Guimli/Vectrex-Schematic/LogicBoard 3GE/LogicBoard 3GE B&W.pdf

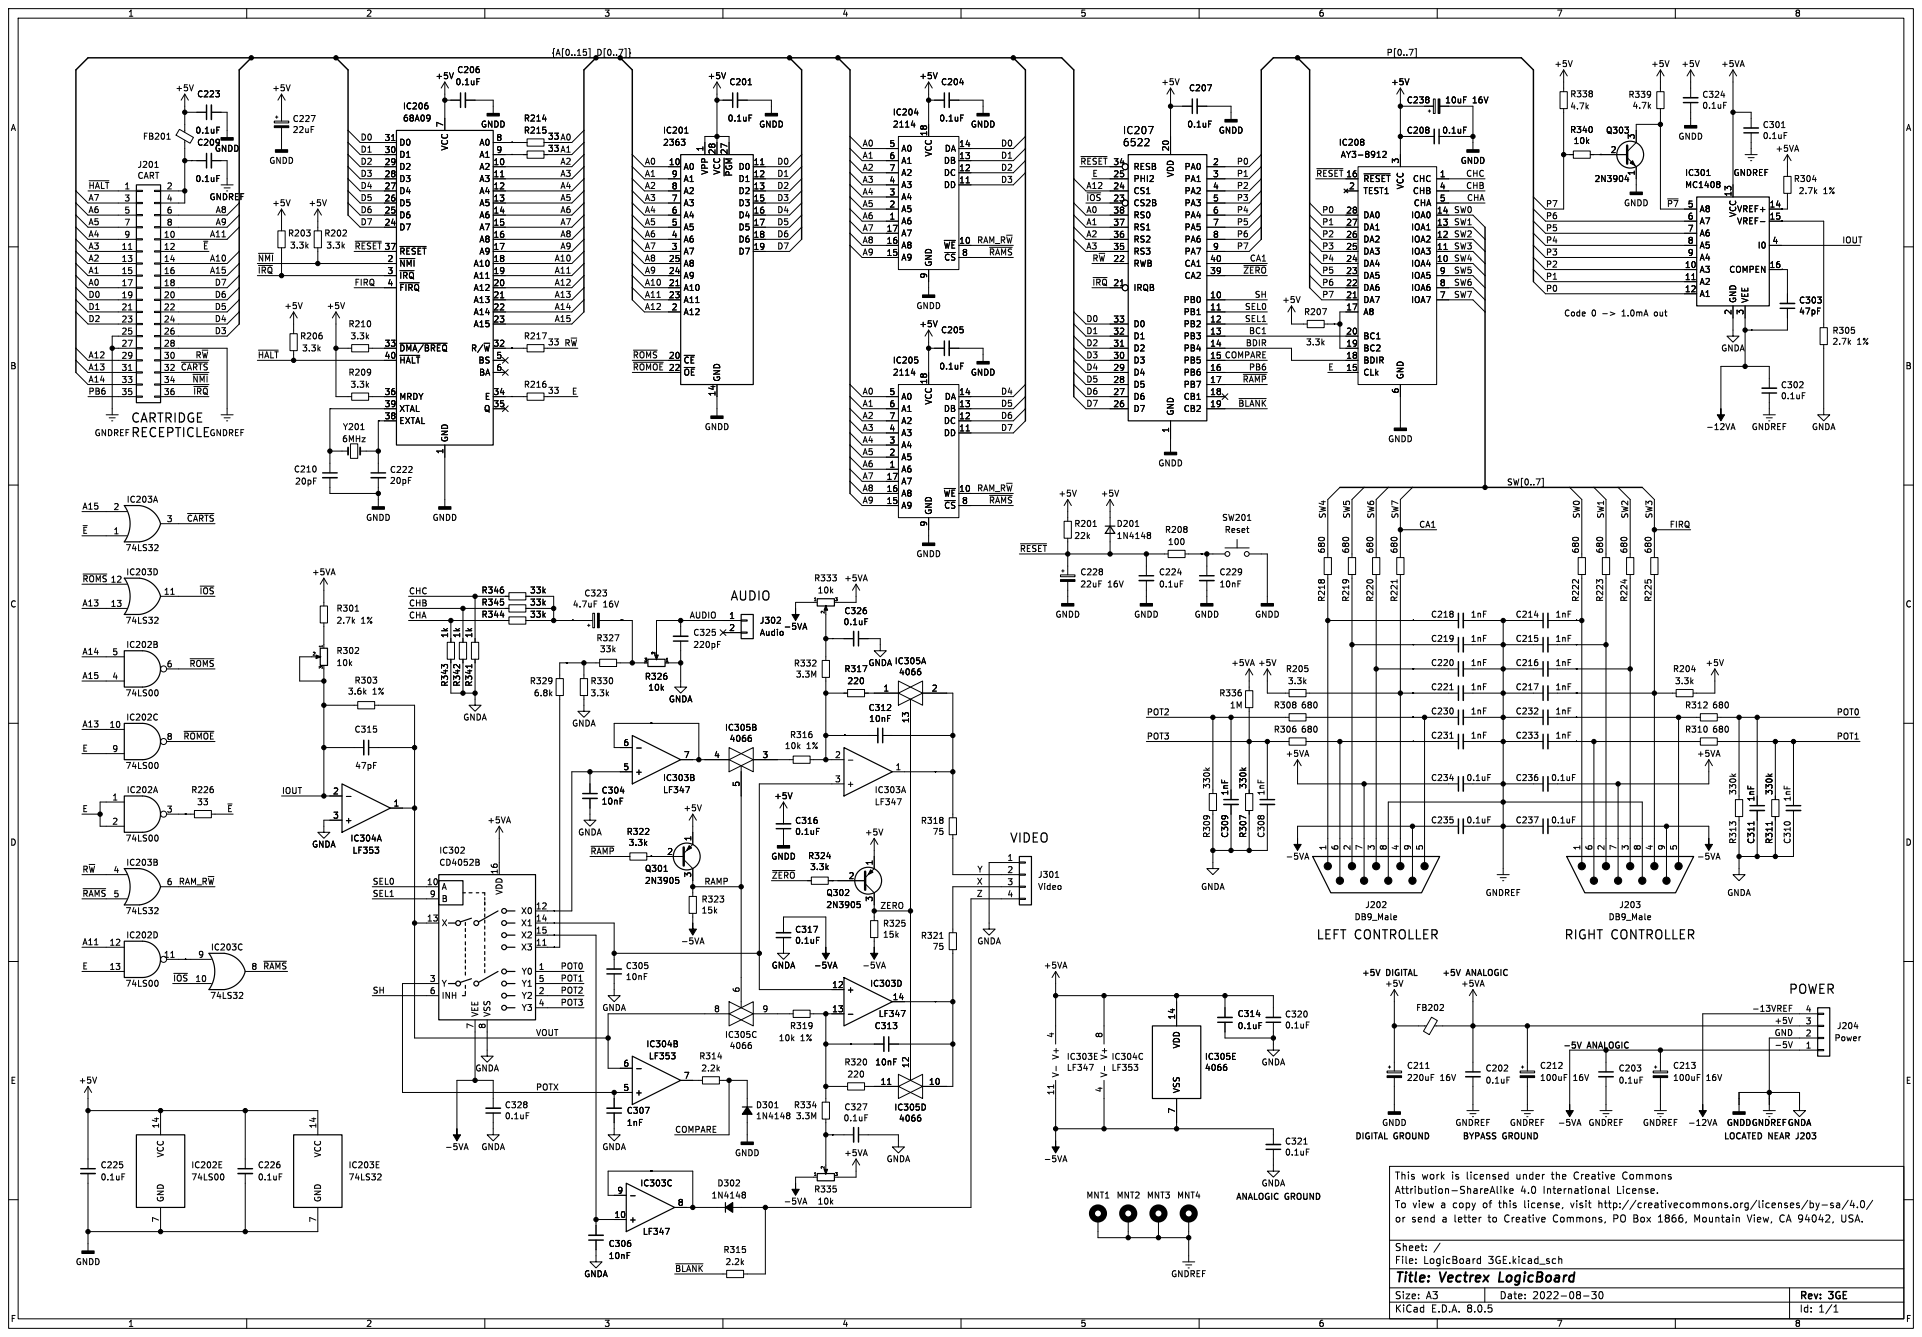
[picture p1: page 1]

1 A2 10 A3 11 A4 12 A5 13 A6 14 A7 15 A8 16 A9 17 A10 18 A11 19 ~{NMI} 2 A12 20 A13 21 A14 22 A15 23 D7 24 D6 25 D5 26 D4 27 D3 28 D2 29 ~{IRQ} 3 D1 30 D0 31 R/~{W}32 ~{DMA/BREQ} 33 E

1 A0 10 D0 11 D1 12 D2 13 GND 14 D3 15 D4 16 D5 17 D6 18 D7 19 A12 2 ~{CE} 20 A10 21 ~{OE} 22 A11 23 A9 24 A8 25 ~{PGM} 27 VCC 28 A7 3 A6 4 A5 5 A4 6 A3 7 A2 8 A1 9

Id: 1/1 Title: Vectrex LogicBoard
