Guimli/Vectrex-Schematic/PowerBoard/PowerBoard B&W.pdf

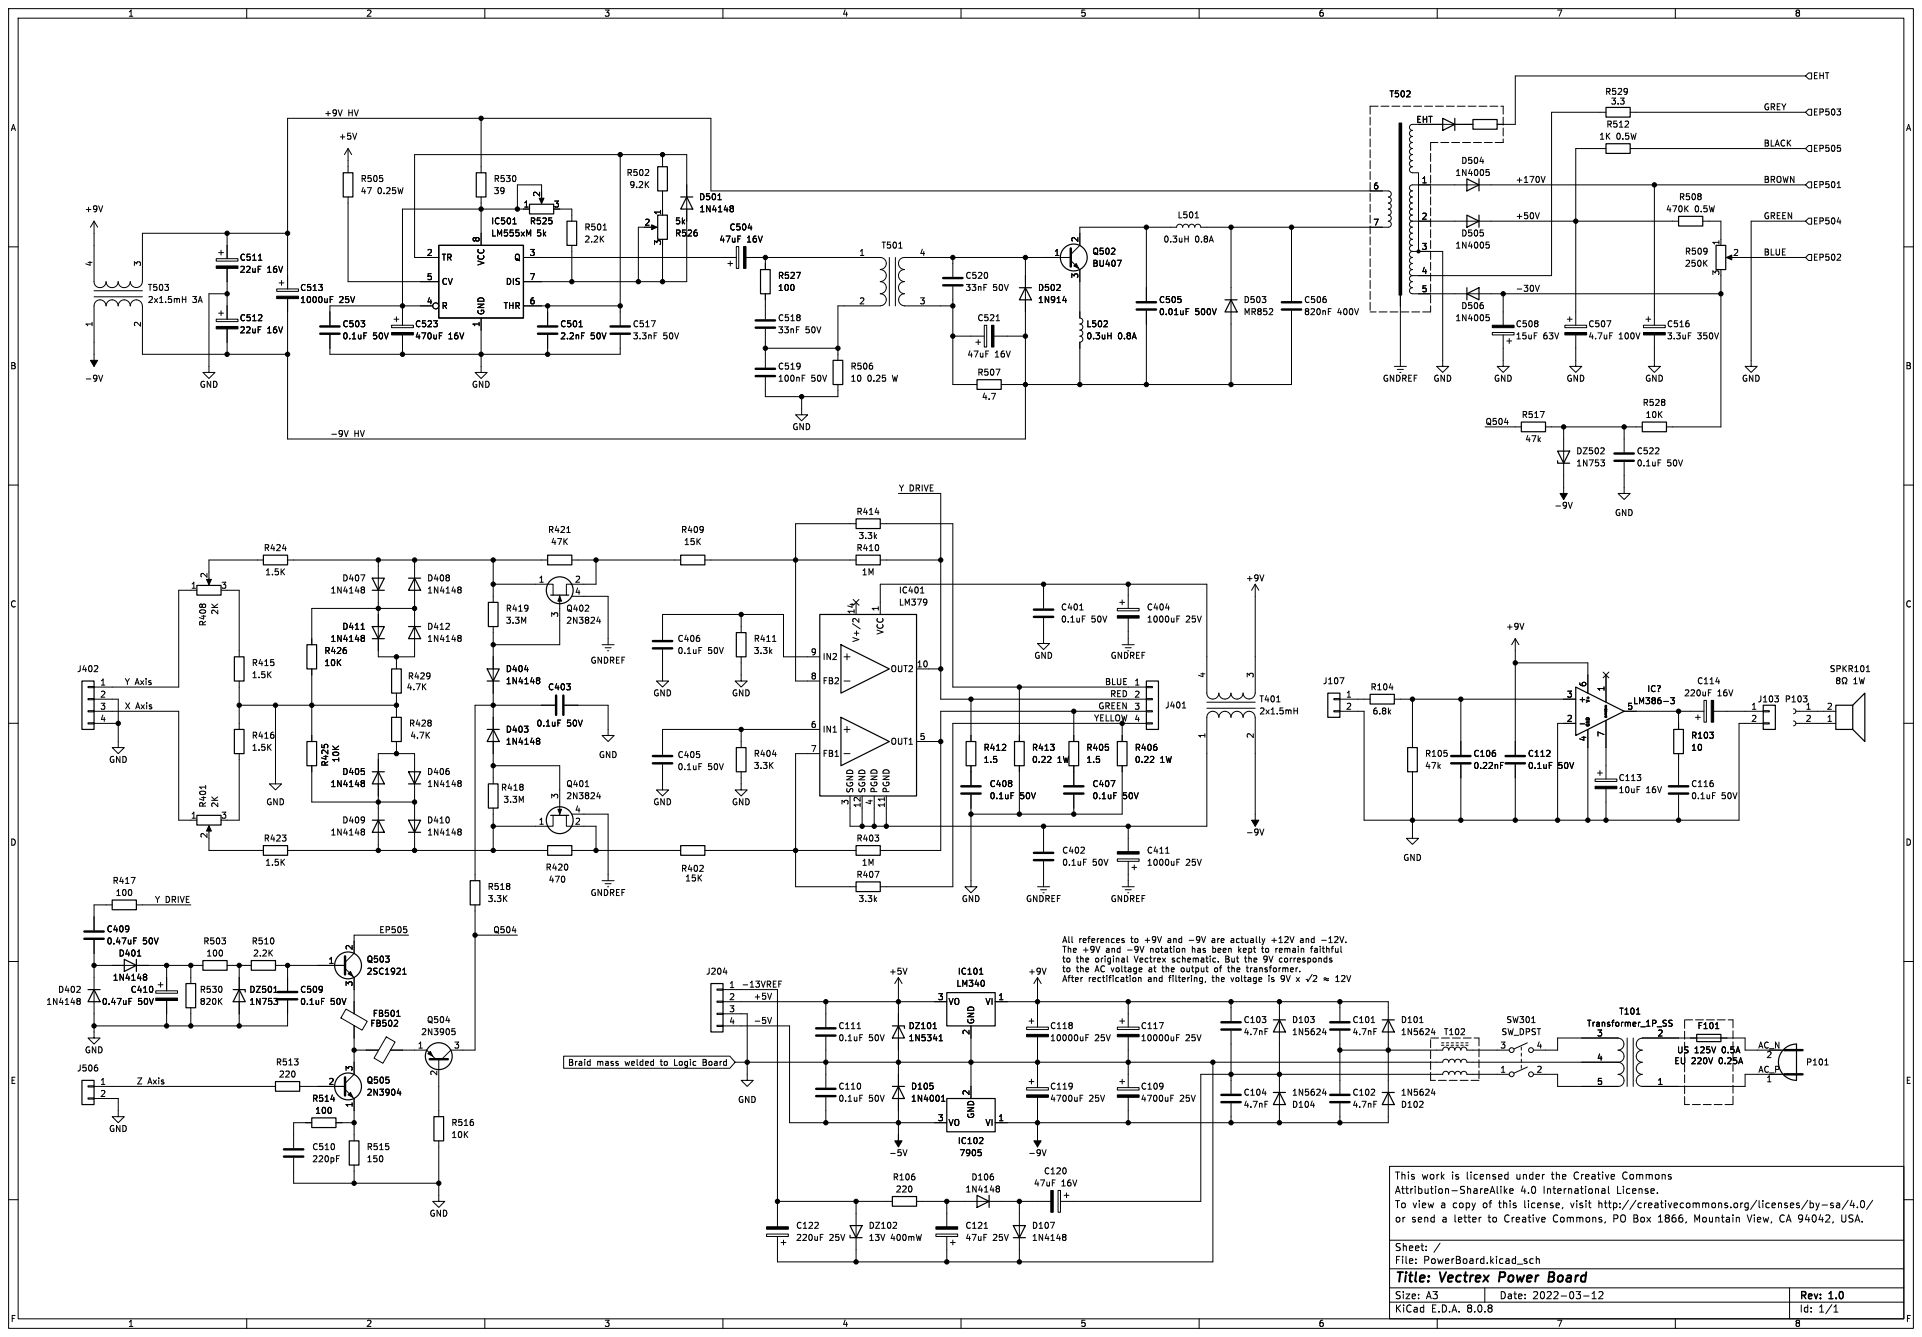
[picture p2: page 1]

Id: 1/1 Title: Vectrex Power Board
