Guimli/Vectrex-Schematic/PowerBoard/PowerBoard Color.pdf

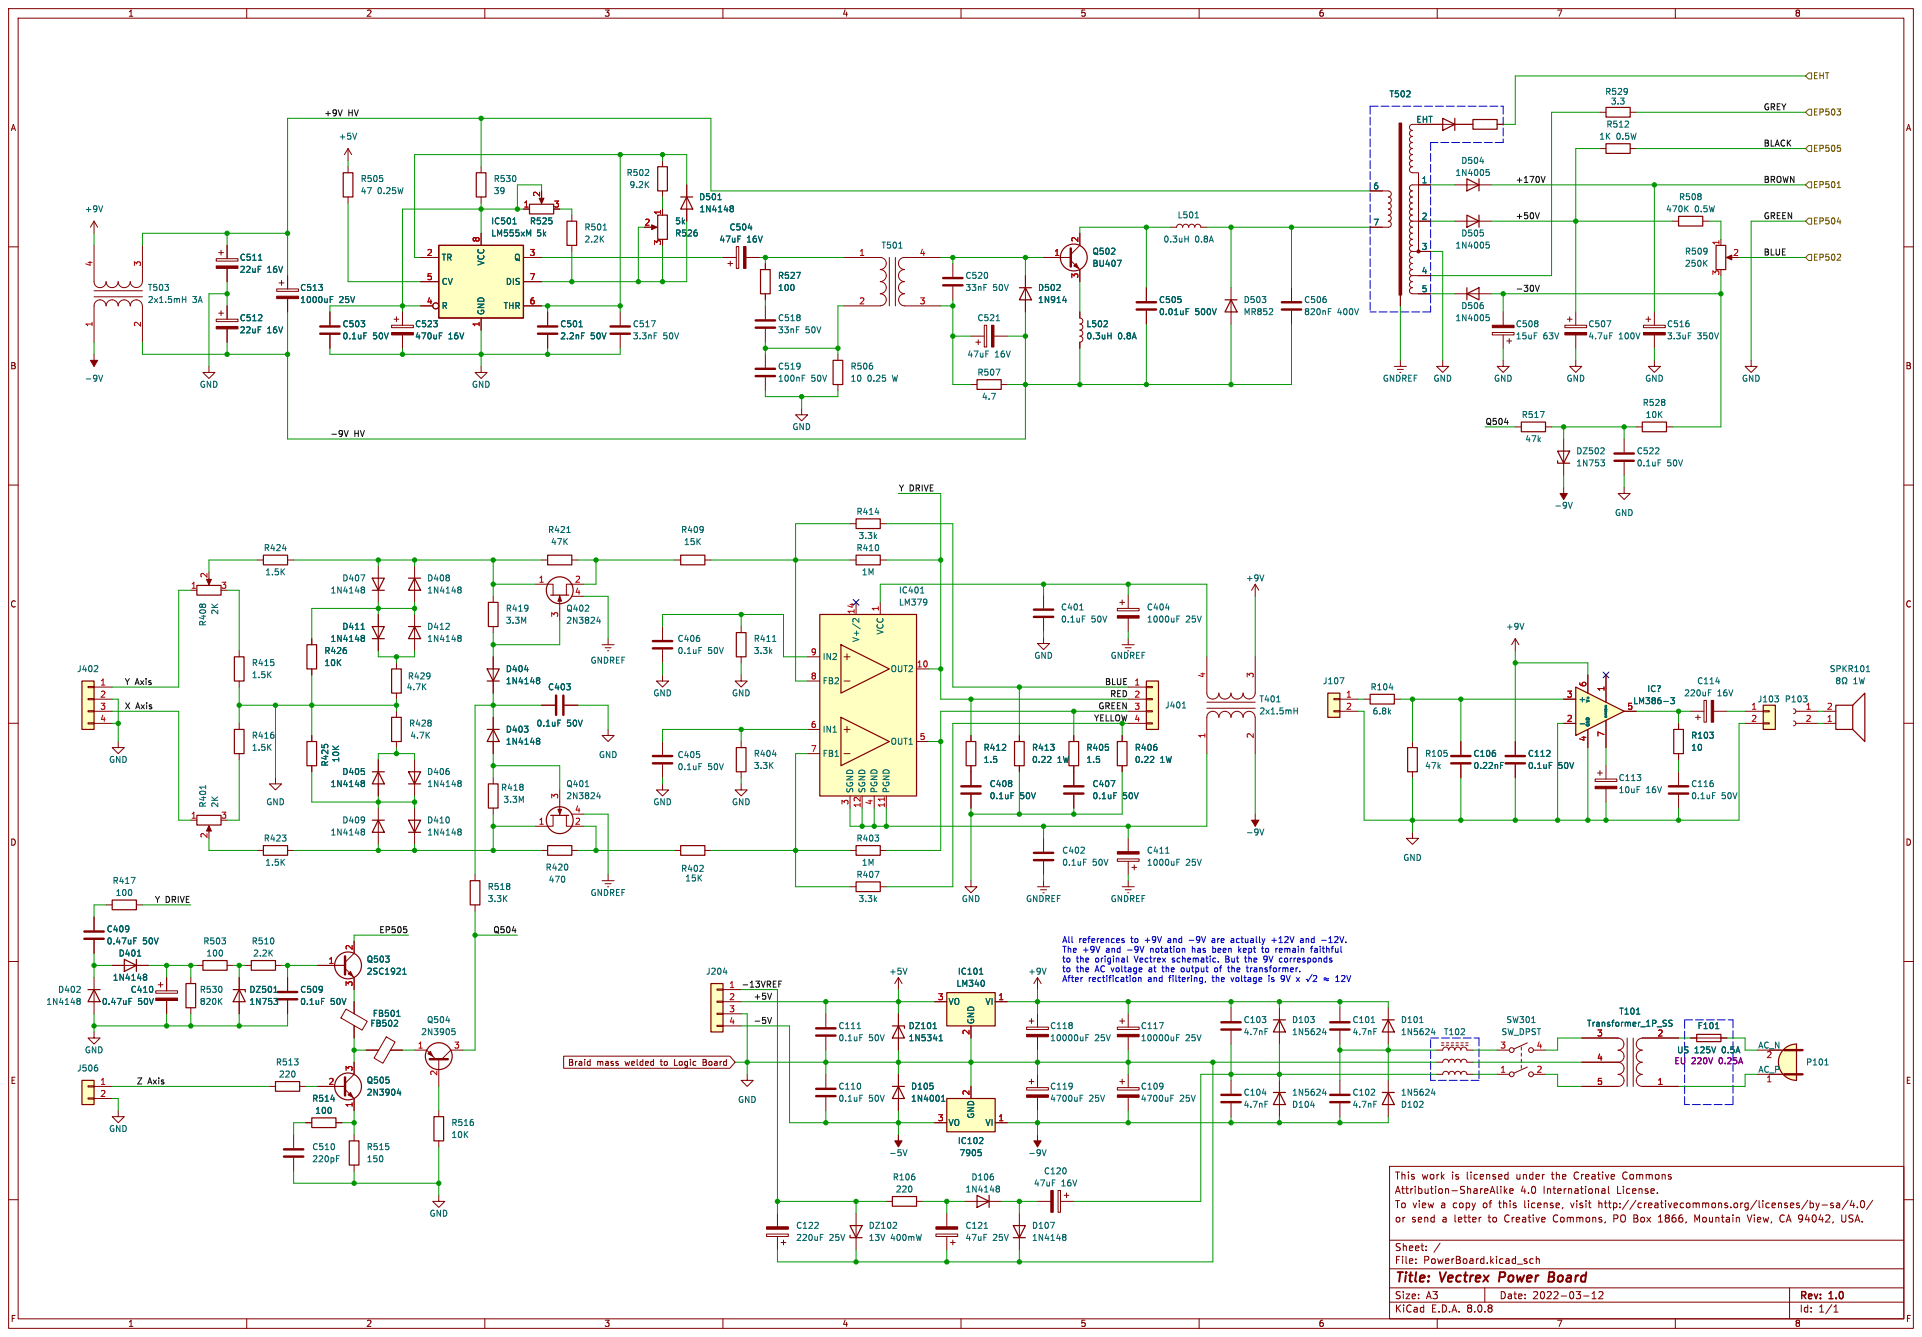
[picture p3: page 1]

Id: 1/1 Title: Vectrex Power Board
