Guimli/Vectrex-Schematic/CRTBoard/CRTBoard Color.pdf

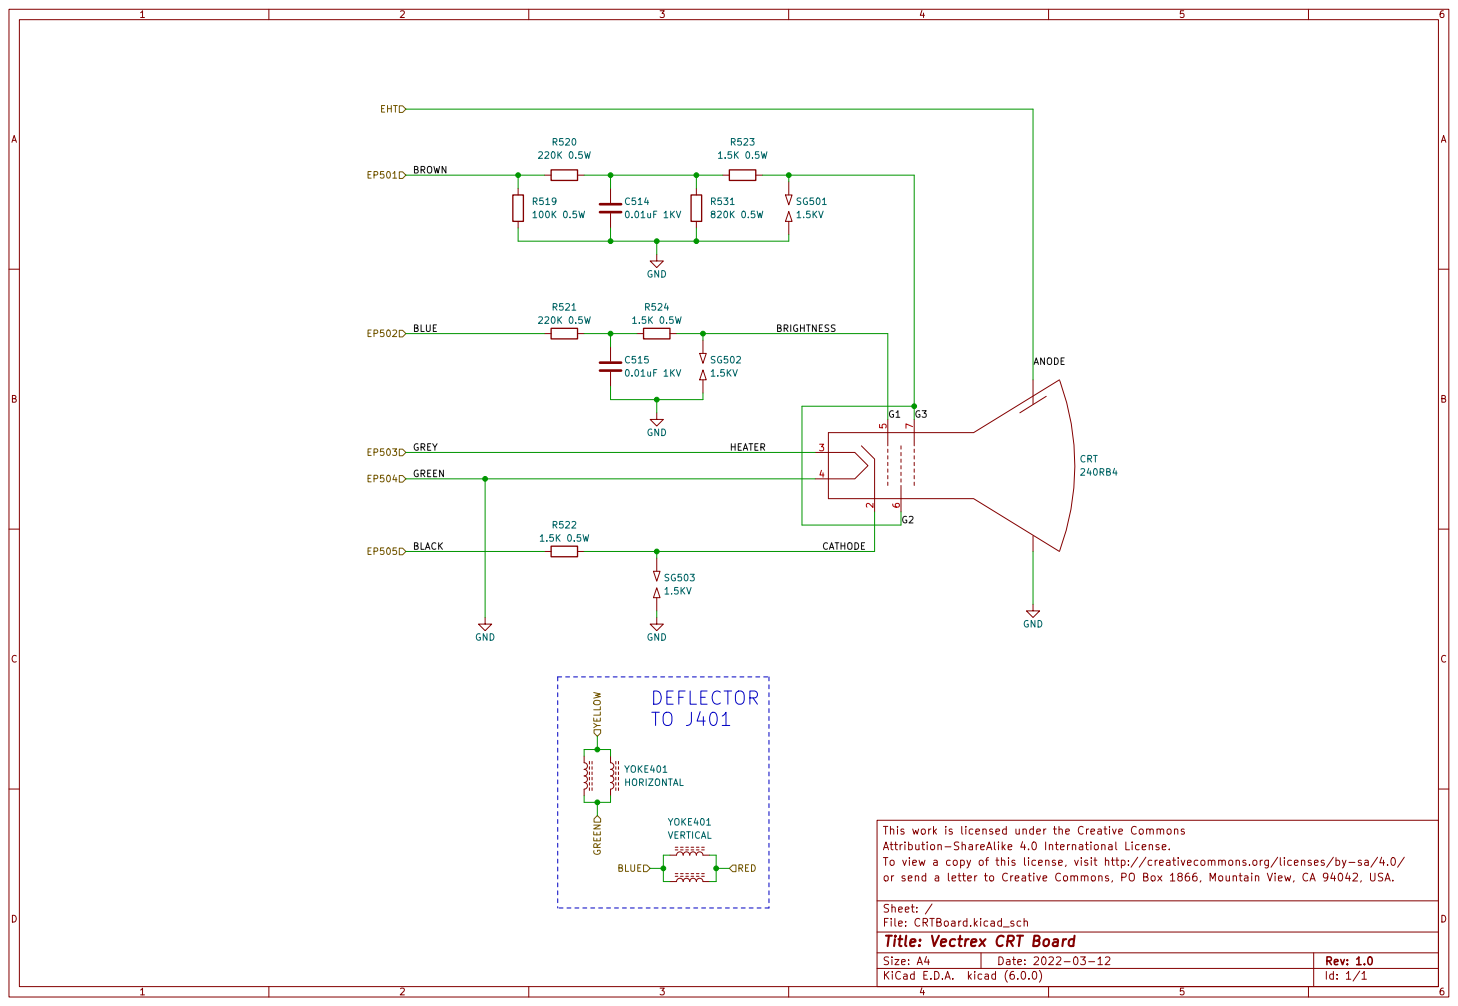
[picture p4: page 1]

To view a copy of this license, visit http://creativecommons.org/licenses/by-sa/4.0/ Attribution-ShareAlike 4.0 International License. This work is licensed under the Creative Commons YOKE401 HORIZONTAL C515

File: CRTBoard.kicad_sch Sheet: / or send a letter to Creative Commons, PO Box 1866, Mountain View, CA 94042, USA.

Id: 1/1 Title: Vectrex CRT Board
