Guimli/Vectrex-Schematic/CRTBoard/CRTBoard.kicad_sch

## KiCad design CRTBoard/CRTBoard.kicad_sch (2025-01-22)

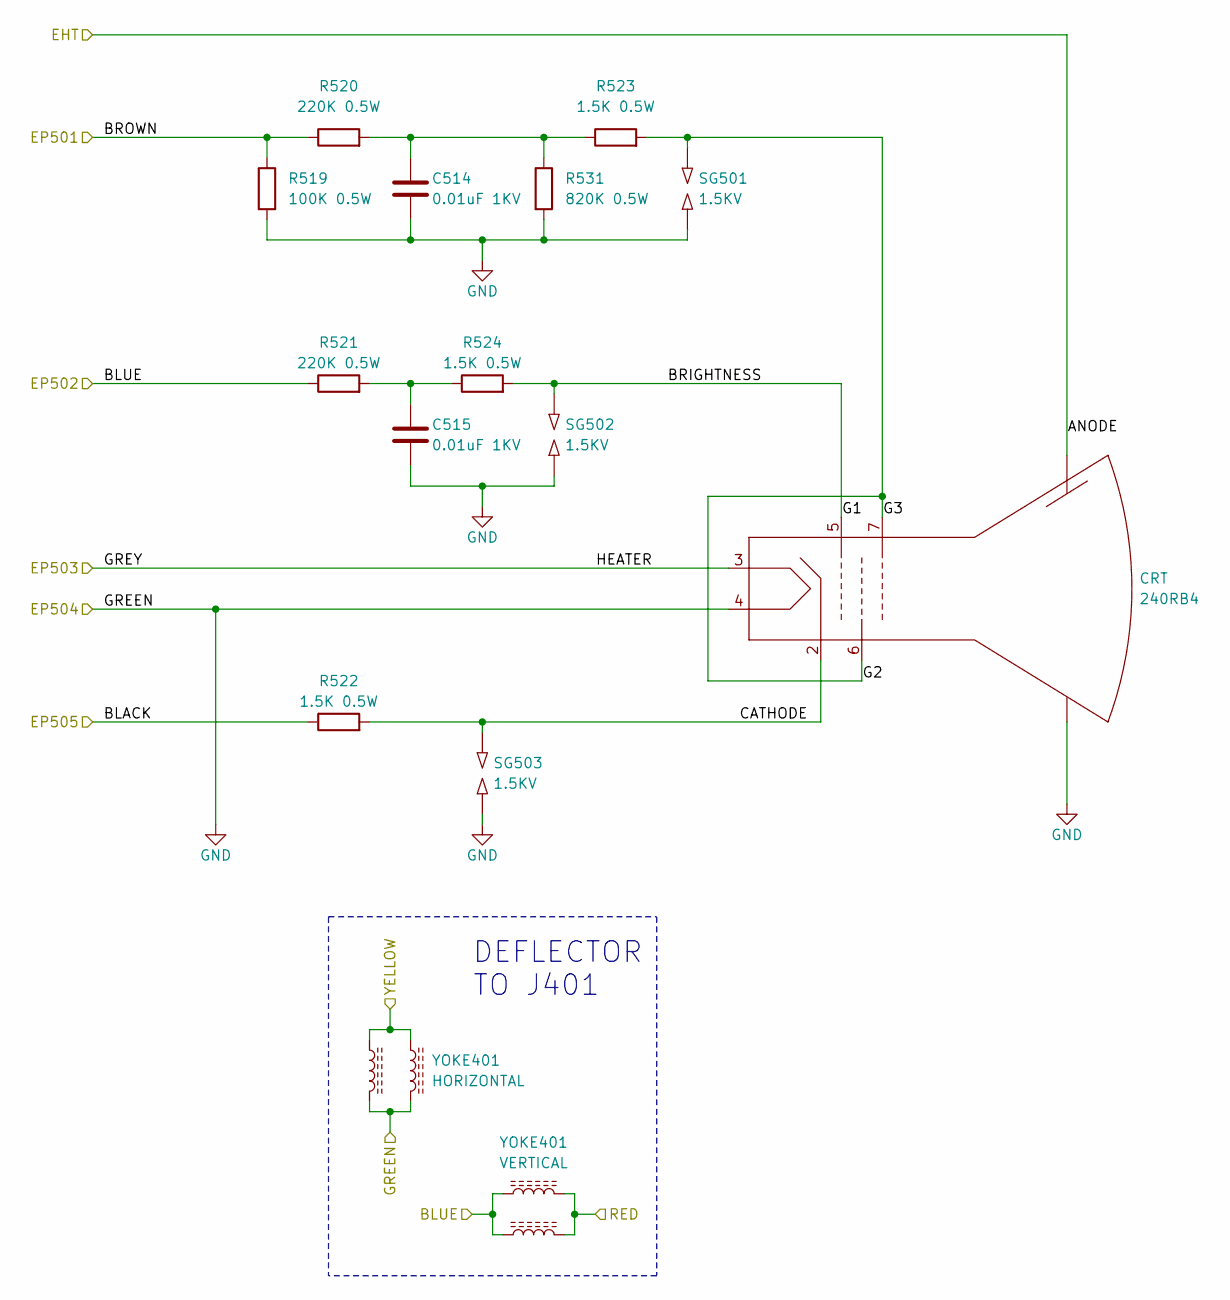
[picture p5: schematic CRTBoard.kicad_sch]

Parts:
C514, C515: 0.01uF 1KV
CRT: 240RB4
R519: 100K 0.5W
R520, R521: 220K 0.5W
R522, R523, R524: 1.5K 0.5W
R531: 820K 0.5W
SG501, SG502, SG503: 1.5KV
YOKE401: HORIZONTAL

Connections:
ANODE: CRT.
BLACK: R522.1
BLUE: R521.1, YOKE401.1
BRIGHTNESS: CRT.5, R524.2, SG502.2
BROWN: R519.1, R520.1
CATHODE: CRT.2, R522.2, SG503.2
EP503: CRT.3
EP504: CRT.4
G2: CRT.6, CRT.7, R523.2, SG501.2
GREEN: YOKE401.2
unnamed: C514.1, R520.2, R523.1, R531.1
unnamed: C514.2, R519.2, R531.2, SG501.1
unnamed: C515.1, R521.2, R524.1
unnamed: C515.2, SG502.1
RED: YOKE401.2
YELLOW: YOKE401.1

Notes on the sheet:
DEFLECTOR TO J401
