Guimli/Vectrex-Schematic/LogicBoard 3GE/LogicBoard 3GE.kicad_sch

## KiCad design LogicBoard 3GE/LogicBoard 3GE.kicad_sch (2025-01-22)

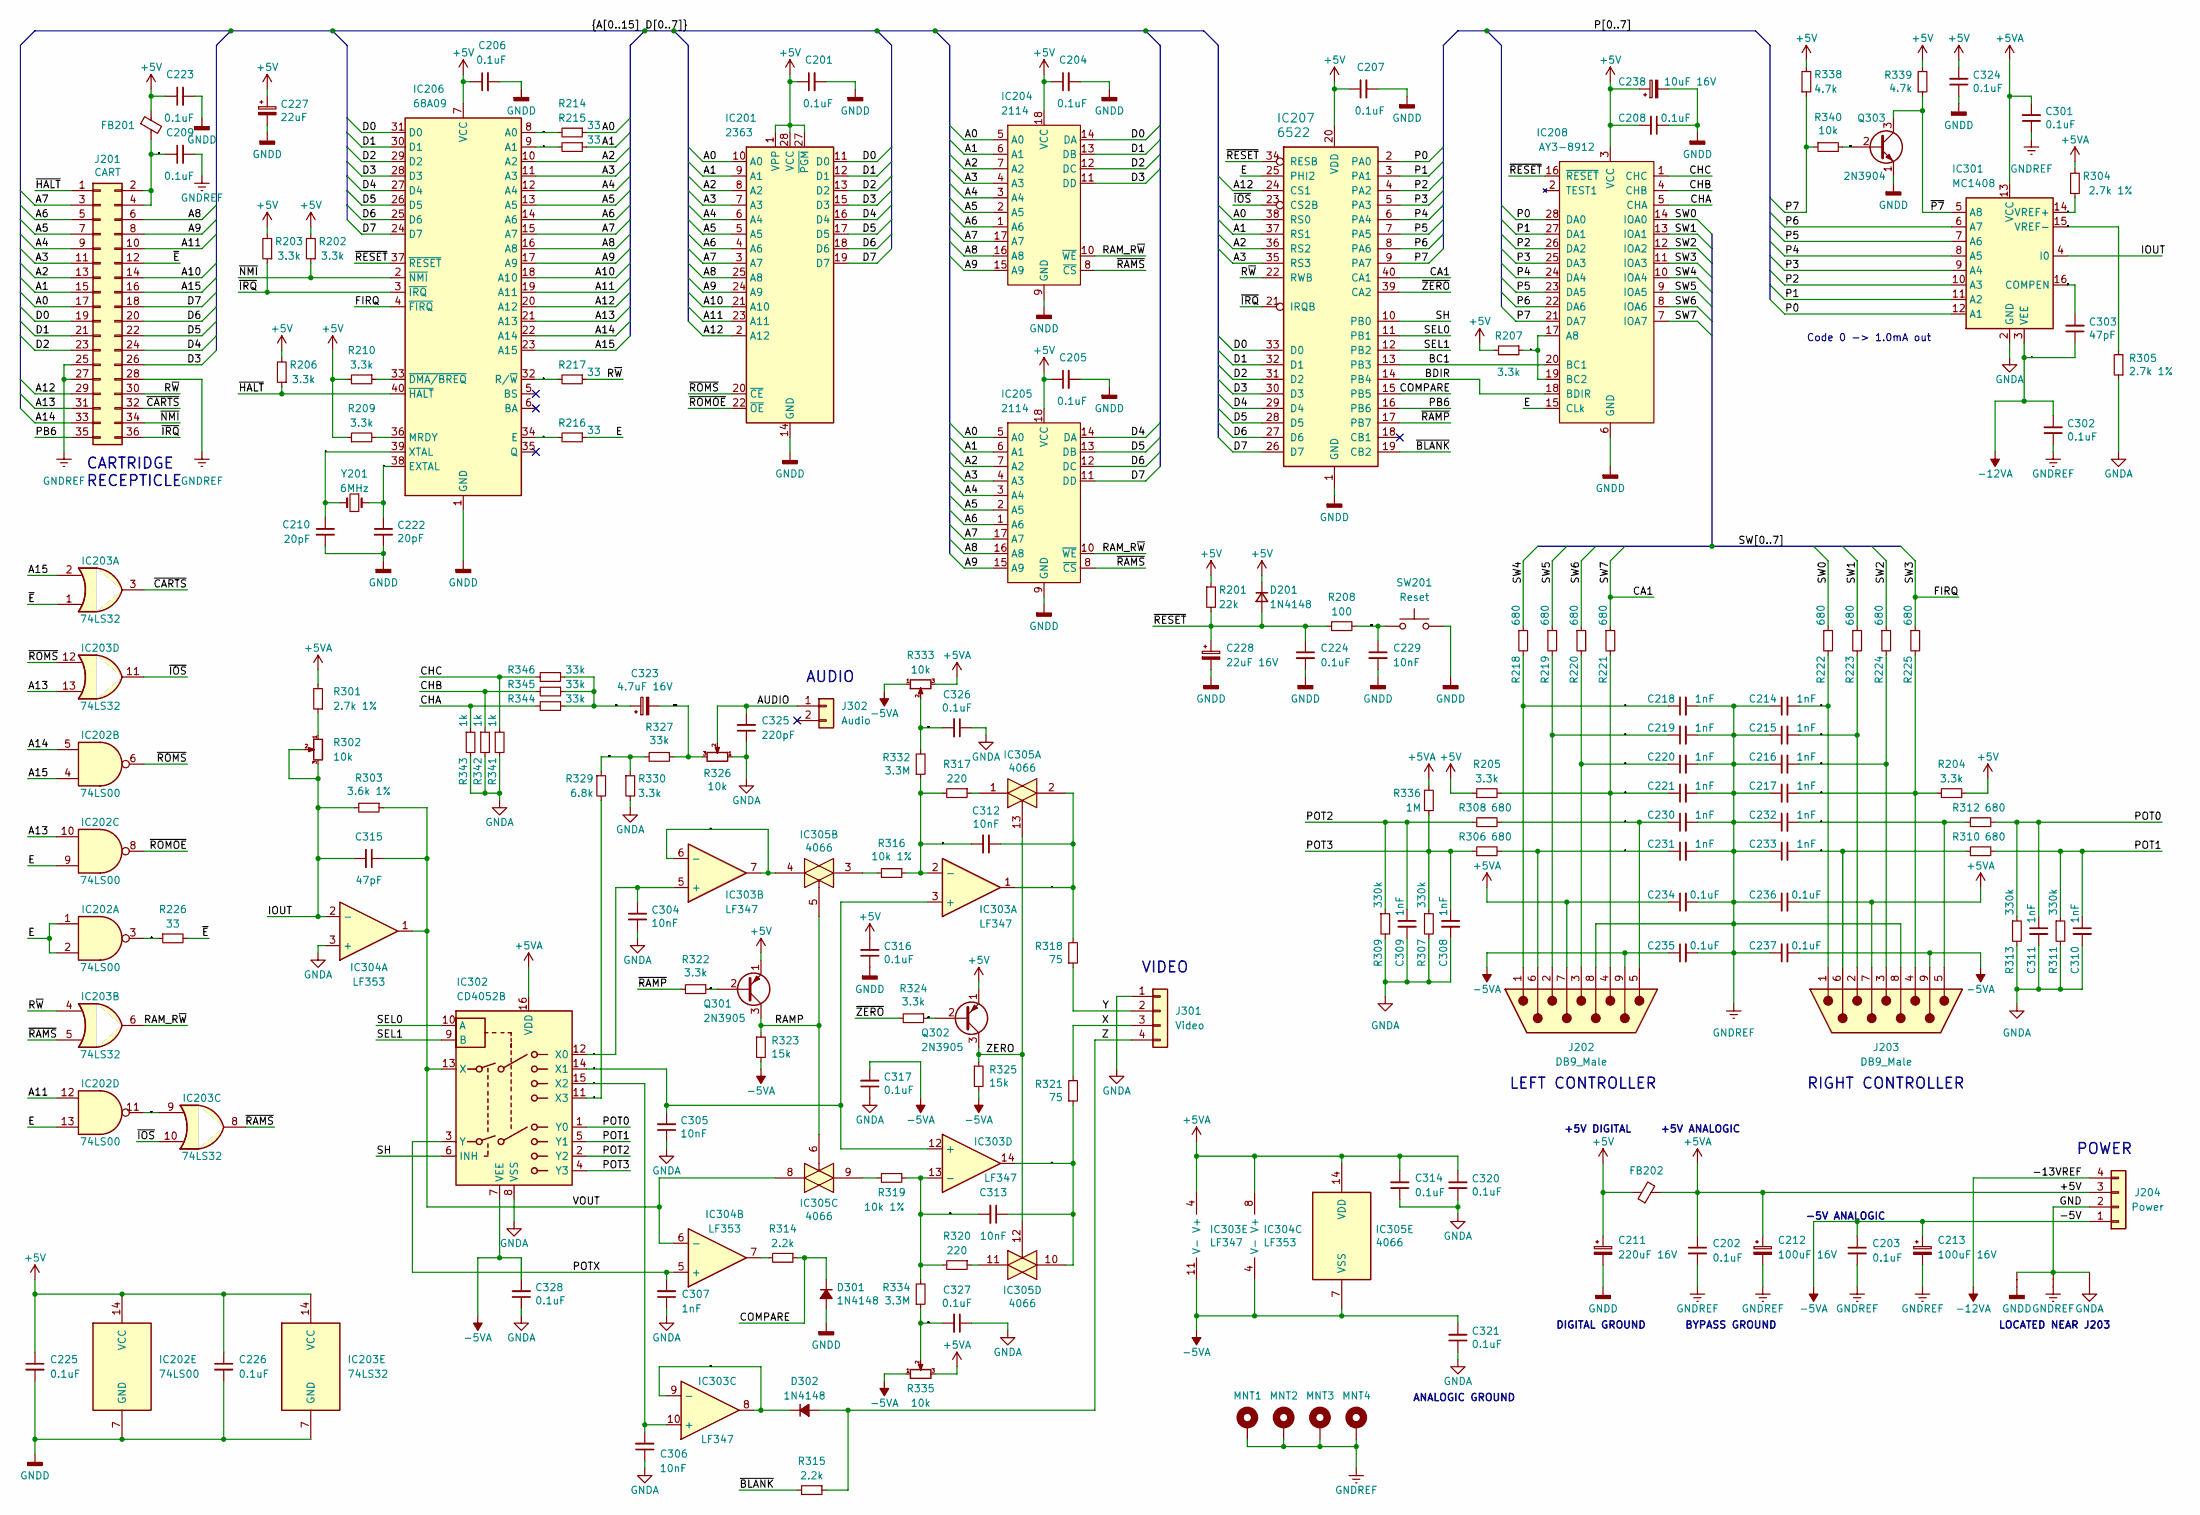
[picture p6: schematic LogicBoard 3GE.kicad_sch]

Parts:
C201, C204, C205, C206, C207, C208, C209, C223, C301, C302, C314, C316, C317, C320, C321, C324, C326, C327, C328: 0.1uF; C_Disc_D5.0mm_W2.5mm_P5.00mm; Mouser 581-SR215C104k
C202, C203, C224, C225, C226, C234, C235, C236, C237: 0.1uF; C_Disc_D5.0mm_W2.5mm_P5.00mm
C210, C222: 20pF; C_Disc_D5.0mm_W2.5mm_P5.00mm; Mouser 581-SR215A220kARTR1
C211: 220uF 16V; CP_Radial_D8.0mm_P2.50mm
C212, C213: 100uF 16V; CP_Radial_D8.0mm_P2.50mm
C214, C215, C216, C217, C218, C219, C220, C221, C230, C231, C232, C233: 1nF; C_Disc_D5.0mm_W2.5mm_P5.00mm
C227: 22uF; CP_Radial_Tantal_D5.5mm_P2.50mm; Mouser 647-UPW1A220MDD6TP
C228: 22uF 16V; CP_Radial_Tantal_D5.0mm_P2.50mm
C229: 10nF; C_Disc_D5.0mm_W2.5mm_P5.00mm
C238: 10uF 16V; CP_Radial_Tantal_D5.0mm_P2.50mm
C303, C315: 47pF; C_Disc_D5.0mm_W2.5mm_P5.00mm; Mouser 581-SR211A470JAR
C304, C305, C306: 10nF; C_Disc_D7.5mm_W5.0mm_P5.00mm; Mouser 810-FG28C0G2A472JRT6
C307, C308, C309, C310, C311: 1nF; C_Disc_D5.0mm_W2.5mm_P5.00mm; Mouser 581-SR211A102JAR
C312, C313: 10nF; C_Disc_D7.5mm_W5.0mm_P5.00mm; Mouser 810-FG28C0G2A103JRT6
C323: 4.7uF 16V; CP_Radial_D4.0mm_P2.00mm; Mouser 647-UkT1E4R7MDD1TD
C325: 220pF; C_Disc_D5.0mm_W2.5mm_P5.00mm; Mouser 581-SR211A221JAATR
D201: 1N4148; D_DO-34_SOD68_P12.70mm_Horizontal
D301, D302: 1N4148; D_DO-34_SOD68_P12.70mm_Horizontal; Mouser 512-1N4148
FB201, FB202: 96Ω @ 25MHz; L_Axial_L7.0mm_D3.3mm_P12.70mm_Horizontal_Fastron_MICC; Mouser 623-2743007112
IC201: 2363; DIP-28_W15.24mm
IC202: 74LS00; DIP-14_W7.62mm; Mouser 595-SN74LS00N
IC203: 74LS32; DIP-14_W7.62mm; Mouser 595-SN74LS32N
IC204, IC205: 2114; DIP-18_W7.62mm
IC206: 68A09; DIP-40_W15.24mm
IC207: 6522; DIP-40_W15.24mm; Mouser 955-W65C22S6TPG-14
IC208: AY3-8912; DIP-28_W15.24mm
IC301: MC1408; DIP-16_W7.62mm; Mouser 926-DAC0808LCN/NOPB
IC302: CD4052B; DIP-16_W7.62mm; Mouser 595-CD4052BE
IC303: LF347; DIP-14_W7.62mm; Mouser 595-LF347N
IC304: LF353; DIP-8_W7.62mm; Mouser 595-LF353P
IC305: 4066; DIP-14_W7.62mm; Mouser 595-CD4066BE
J201: CART; SULLINS_EBC18DRAS; Mouser 587-395-036
J202, J203: DB9_Male; DSUB-9_Male_Horizontal_Vectrex
J204: Power; Molex_KK-396_A-41791-0004_1x04_P3.96mm_Vertical
J301: Video; Molex_KK-254_AE-6410-04A_1x04_P2.54mm_Vertical
J302: Audio; Molex_KK-254_AE-6410-02A_1x02_P2.54mm_Vertical
MNT1, MNT2, MNT3, MNT4: MountingHole_Pad; MountingHole_3.5mm_Pad
Q301, Q302: 2N3905; TO-92_Wide
Q303: 2N3904; TO-92_Wide; Mouser 512-2N3904TA
R201: 22k; R_Axial_DIN0207_L6.3mm_D2.5mm_P12.70mm_Horizontal
R202, R203, R206, R207, R209, R210, R322, R324: 3.3k; R_Axial_DIN0207_L6.3mm_D2.5mm_P12.70mm_Horizontal; Mouser 603-CFR-25JR-523k3
R204, R205: 3.3k; R_Axial_DIN0207_L6.3mm_D2.5mm_P12.70mm_Horizontal
R208: 100; R_Axial_DIN0207_L6.3mm_D2.5mm_P12.70mm_Horizontal
R214, R215, R216, R217, R226: 33; R_Axial_DIN0207_L6.3mm_D2.5mm_P12.70mm_Horizontal; Mouser 603-CFR-25JR-5233R
R218, R219, R220, R221, R222, R223, R224, R225, R306, R308, R310, R312: 680; R_Axial_DIN0207_L6.3mm_D2.5mm_P12.70mm_Horizontal
R301, R304, R305: 2.7k 1%; R_Axial_DIN0207_L6.3mm_D2.5mm_P12.70mm_Horizontal; Mouser 603-MFR-25FRF522k49
R302: 10k; Potentiometer_ACP_CA14-H5_Horizontal; Mouser 531-PT10H-5k-S
R303: 3.6k 1%; R_Axial_DIN0207_L6.3mm_D2.5mm_P12.70mm_Horizontal; Mouser 603-MFR-25FRF52-2k61
R307, R309, R311, R313: 330k; R_Axial_DIN0207_L6.3mm_D2.5mm_P12.70mm_Horizontal; Mouser 603-CFR-25JR-52-330k
R314, R315: 2.2k; R_Axial_DIN0207_L6.3mm_D2.5mm_P12.70mm_Horizontal; Mouser 603-CFR-25JR-522k2
R316, R319: 10k 1%; R_Axial_DIN0207_L6.3mm_D2.5mm_P12.70mm_Horizontal; Mouser 603-MFR-25FRF5210k
R317, R320: 220; R_Axial_DIN0207_L6.3mm_D2.5mm_P12.70mm_Horizontal; Mouser 603-CFR-25JR-52220R
R318, R321: 75; R_Axial_DIN0207_L6.3mm_D2.5mm_P12.70mm_Horizontal; Mouser 603-MFR-25FTE52-3M3
R323, R325: 15k; R_Axial_DIN0207_L6.3mm_D2.5mm_P12.70mm_Horizontal; Mouser 603-CFR-25JR-5215k
R326: 10k; Potentiometer_UndLab_Horizontal; Mouser 531-PT10H-10k-S
R327, R344, R345, R346: 33k; R_Axial_DIN0207_L6.3mm_D2.5mm_P12.70mm_Horizontal; Mouser 603-CFR-25JR-52-33k
R329: 6.8k; R_Axial_DIN0207_L6.3mm_D2.5mm_P12.70mm_Horizontal; Mouser 603-CFR-25JR-52-33k
R330: 3.3k; R_Axial_DIN0207_L6.3mm_D2.5mm_P12.70mm_Horizontal; Mouser 603-CFR-25JR-52-33k
R332, R334: 3.3M; R_Axial_DIN0207_L6.3mm_D2.5mm_P12.70mm_Horizontal; Mouser 603-MFR-25FTE52-3M3
R333, R335: 10k; Potentiometer_ACP_CA14-H5_Horizontal; Mouser 531-PT10H-10k-S
R336: 1M; R_Axial_DIN0207_L6.3mm_D2.5mm_P12.70mm_Horizontal; Mouser 603-CFR-25JR-52-330k
R338, R339: 4.7k; R_Axial_DIN0207_L6.3mm_D2.5mm_P12.70mm_Horizontal; Mouser 603-CFR-25JR-524k7
R340: 10k; R_Axial_DIN0207_L6.3mm_D2.5mm_P12.70mm_Horizontal; Mouser 603-CFR-25JR-5210k
R341, R342, R343: 1k; R_Axial_DIN0207_L6.3mm_D2.5mm_P12.70mm_Horizontal; Mouser 603-CFR-25JR-521k
SW201: Reset; TestPoint_Bridge_Pitch5.08mm_Drill1.3mm
W1, W2, W3: W
Y201: 6MHz; Crystal_HC49-U_Horizontal_1EP_style3; Mouser 815-AB-6-B2

Connections:
+5V: C201.1, C204.1, C205.1, C206.1, C207.1, C208.2, C211.1, C223.1, C225.1, C226.1, C227.1, C238.1, C316.2, C324.2, D201.1 (k), FB201.1, FB202.1, IC201.1 (VPP), IC201.27 (~PGM), IC201.28 (VCC), IC202.14 (VCC), IC203.14 (VCC), IC204.18 (VCC), IC205.18 (VCC), IC206.7 (VCC), IC207.20 (VDD), IC208.3 (VCC), Q301.1 (E), Q302.1 (E), R201.1, R202.2, R203.2, R204.2, R205.1, R206.2, R207.2, R209.1, R210.2, R338.2, R339.2
+5VA: C202.1, C212.1, C234.1, C236.2, C301.2, C314.2, C320.2, FB202.2, IC301.13 (VCC), IC302.16 (VDD), IC303.4 (V+), IC304.8 (V+), IC305.14 (VDD), J202.7, J203.7, J204.3, R301.2, R304.2, R333.3, R335.3, R336.1
+5V_CART: C209.1, FB201.2, J201.2, J201.4
-5VA: C203.1, C213.1, C235.1, C237.2, C317.2, C321.2, C328.2, IC302.7 (VEE), IC303.11 (V-), IC304.4 (V-), IC305.7 (VSS), J202.9, J203.9, J204.1, R323.2, R325.2, R333.1, R335.1
-13VREF: J204.4
A0: IC201.10 (A0), IC204.5 (A0), IC205.5 (A0), IC207.38 (RS0), J201.17, R214.1
A1: IC201.9 (A1), IC204.6 (A1), IC205.6 (A1), IC207.37 (RS1), J201.15, R215.1
A2: IC201.8 (A2), IC204.7 (A2), IC205.7 (A2), IC206.10 (A2), IC207.36 (RS2), J201.13
A3: IC201.7 (A3), IC204.4 (A3), IC205.4 (A3), IC206.11 (A3), IC207.35 (RS3), J201.11
A4: IC201.6 (A4), IC204.3 (A4), IC205.3 (A4), IC206.12 (A4), J201.9
A5: IC201.5 (A5), IC204.2 (A5), IC205.2 (A5), IC206.13 (A5), J201.7
A6: IC201.4 (A6), IC204.1 (A6), IC205.1 (A6), IC206.14 (A6), J201.5
A7: IC201.3 (A7), IC204.17 (A7), IC205.17 (A7), IC206.15 (A7), J201.3
A8: IC201.25 (A8), IC204.16 (A8), IC205.16 (A8), IC206.16 (A8), J201.6
A9: IC201.24 (A9), IC204.15 (A9), IC205.15 (A9), IC206.17 (A9), J201.8
A10: IC201.21 (A10), IC206.18 (A10), J201.14
A11: IC201.23 (A11), IC202.12, IC206.19 (A11), J201.10
A12: IC201.2 (A12), IC206.20 (A12), IC207.24 (CS1), J201.29
A13: IC202.10, IC203.13, IC206.21 (A13), J201.31
A14: IC202.5, IC206.22 (A14), J201.33
A15: IC202.4, IC203.2, IC206.23 (A15), J201.16
AUDIO: C325.2, J302.1, R326.2
BC1: IC207.13 (PB3), IC208.20 (BC1)
BC2: IC208.17 (A8), IC208.19 (BC2), R207.1
BDIR: IC207.14 (PB4), IC208.18 (BDIR)
CA1: IC207.40 (CA1), IC208.7 (IOA7), R221.1
CH(A+B+C): C323.1, R344.1, R345.1, R346.1
CH(A+B+C)+DIGITAL_AUDIO: C323.2, R326.3, R327.1
CHA: IC208.5 (CHA), R343.1, R344.2
CHB: IC208.4 (CHB), R342.1, R345.2
CHC: IC208.1 (CHC), R341.1, R346.2
COMPARE: D301.1 (k), IC207.15 (PB5), R314.1
COMPEN: C303.2, IC301.16 (COMPEN)
CPU_A0: IC206.8 (A0), R214.2
CPU_A1: IC206.9 (A1), R215.2
CPU_E: IC206.34 (E), R216.2
CPU_R~W: IC206.32 (R/~W), R217.2
D0: IC201.11 (D0), IC204.14 (DA), IC206.31 (D0), IC207.33 (D0), J201.19
D1: IC201.12 (D1), IC204.13 (DB), IC206.30 (D1), IC207.32 (D1), J201.21
D2: IC201.13 (D2), IC204.12 (DC), IC206.29 (D2), IC207.31 (D2), J201.23
D3: IC201.15 (D3), IC204.11 (DD), IC206.28 (D3), IC207.30 (D3), J201.26
D4: IC201.16 (D4), IC205.14 (DA), IC206.27 (D4), IC207.29 (D4), J201.24
D5: IC201.17 (D5), IC205.13 (DB), IC206.26 (D5), IC207.28 (D5), J201.22
D6: IC201.18 (D6), IC205.12 (DC), IC206.25 (D6), IC207.27 (D6), J201.20
D7: IC201.19 (D7), IC205.11 (DD), IC206.24 (D7), IC207.26 (D7), J201.18
DIGITAL_AUDIO: R327.2, R329.1, R330.1
E: IC202.1, IC202.2, IC202.9, IC202.13, IC207.25 (PHI2), IC208.15 (CLk), R216.1
EXTAL: C222.1, IC206.38 (EXTAL), Y201.1
FIRQ: IC206.4 (~FIRQ), IC208.11 (IOA3), R225.1
GND: J204.2, W1.2, W2.2, W3.2
GNDA: C304.2, C305.1, C306.1, C307.1, C308.2, C309.2, C310.2, C311.2, C314.1, C317.1, C320.1, C321.1, C325.1, C326.1, C327.1, C328.1, IC301.2 (GND), IC302.8 (VSS), IC304.3 (+), J301.1, R305.1, R307.2, R309.2, R311.2, R313.2, R326.1, R330.2, R341.2, R342.2, R343.2, W3.1
GNDD: C201.2, C204.2, C205.2, C206.2, C207.2, C208.1, C210.2, C211.2, C222.2, C223.2, C224.2, C225.2, C226.2, C227.2, C228.2, C229.2, C238.2, C316.1, C324.1, D301.2 (A), IC201.14 (GND), IC202.7 (GND), IC203.7 (GND), IC204.9 (GND), IC205.9 (GND), IC206.1 (GND), IC207.1 (GND), IC208.6 (GND), Q303.1 (E), SW201.2, W1.1
GNDREF: C202.2, C203.2, C209.2, C212.2, C213.2, C214.1, C215.1, C216.1, C217.1, C218.2, C219.2, C220.2, C221.2, C230.2, C231.2, C232.1, C233.1, C234.2, C235.2, C236.1, C237.1, C301.1, C302.1, J201.25, J201.27, J201.28, J202.8, J203.8, MNT1.1, MNT2.1, MNT3.1, MNT4.1, W2.1
IC202A_~E: IC202.3, R226.1
IC303A_FB: C312.2, IC303.2 (-), R316.1, R317.2, R332.1
IC303A_Y: C312.1, IC303.1, IC305.2, R318.2
IC303B_FB: IC303.6 (-), IC303.7, IC305.4
IC303C_FB: D302.1 (k), IC303.8, IC303.9 (-)
IC303D_FB: C313.2, IC303.13 (-), R319.1, R320.2, R334.2
IC303D_X: C313.1, IC303.14, IC305.10, R321.1
IOUT: C315.2, IC301.4 (I0), IC304.2 (-), R302.2, R302.3, R303.2
J202_B1: C218.1, J202.1, R218.2
J202_B2: C219.1, J202.2, R219.2
J202_B3: C220.1, J202.3, R220.2
J202_B4: C221.1, J202.4, R205.2, R221.2
J202_X: C230.1, J202.5, R308.2
J202_Y: C231.1, J202.6, R306.2
J203_B1: C214.2, J203.1, R222.2
J203_B2: C215.2, J203.2, R223.2
J203_B3: C216.2, J203.3, R224.2
J203_B4: C217.2, J203.4, R204.1, R225.2
J203_X: C232.2, J203.5, R312.1
J203_Y: C233.2, J203.6, R310.1
unnamed: IC206.33 (~DMA/BREQ), R210.1
unnamed: IC206.36 (MRDY), R209.2
unnamed: IC304.7, R314.2
unnamed: IC305.1, R317.1
unnamed: IC305.3, R316.2
unnamed: IC305.9, R319.2
unnamed: IC305.11, R320.1
unnamed: R301.1, R302.1
P0: IC207.2 (PA0), IC208.28 (DA0), IC301.12 (A1)
P1: IC207.3 (PA1), IC208.27 (DA1), IC301.11 (A2)
P2: IC207.4 (PA2), IC208.26 (DA2), IC301.10 (A3)
P3: IC207.5 (PA3), IC208.25 (DA3), IC301.9 (A4)
P4: IC207.6 (PA4), IC208.24 (DA4), IC301.8 (A5)
P5: IC207.7 (PA5), IC208.23 (DA5), IC301.7 (A6)
P6: IC207.8 (PA6), IC208.22 (DA6), IC301.6 (A7)
P7: IC207.9 (PA7), IC208.21 (DA7), R338.1, R340.1
PB6: IC207.16 (PB6), J201.35
POT0: C311.1, IC302.1 (Y0), R312.2, R313.1
POT1: C310.1, IC302.5 (Y1), R310.2, R311.1
POT2: C309.1, IC302.2 (Y2), R308.1, R309.1
POT3: C308.1, IC302.4 (Y3), R306.1, R307.1, R336.2
POTX: C307.2, IC302.3 (Y), IC304.5 (+)
Q301_BASE: Q301.2 (B), R322.1
Q302_BASE: Q302.2 (B), R324.1
Q303_BASE: Q303.2 (B), R340.2
RAMP: IC305.5, IC305.6, Q301.3 (C), R323.1
RAM_R~W: IC203.6, IC204.10 (~WE), IC205.10 (~WE)
R~W: IC203.4, IC207.22 (RWB), J201.30, R217.1
SEL0: IC207.11 (PB1), IC302.10 (A)
SEL1: IC207.12 (PB2), IC302.9 (B)
SH: IC207.10 (PB0), IC302.6 (INH)
SW0: IC208.14 (IOA0), R222.1
SW1: IC208.13 (IOA1), R223.1
SW2: IC208.12 (IOA2), R224.1
SW4: IC208.10 (IOA4), R218.1
SW5: IC208.9 (IOA5), R219.1
SW6: IC208.8 (IOA6), R220.1
SWITCH_RESET: C229.1, R208.2, SW201.1
VEE: C302.2, C303.1, IC301.3 (VEE)
VOUT: C315.1, IC302.13 (X), IC304.1, IC304.6 (-), IC305.8, R303.1
VREF+: IC301.14 (VREF+), R304.1
VREF-: IC301.15 (VREF-), R305.2
X: J301.3, R321.2
X0: C304.1, IC302.12 (X0), IC303.5 (+)
X1: C305.2, IC302.14 (X1), IC303.3 (+), IC303.12 (+)
X2: C306.2, IC302.15 (X2), IC303.10 (+)
X3: IC302.11 (X3), R329.2
XTAL: C210.1, IC206.39 (XTAL), Y201.2
X_OFFSET: C327.2, R334.1, R335.2
Y: J301.2, R318.1
Y_OFFSET: C326.2, R332.2, R333.2
Z: D302.2 (A), J301.4, R315.1
ZERO: IC305.12, IC305.13, Q302.3 (C), R325.1
~A11&E: IC202.11, IC203.9
~BLANK: IC207.19 (CB2), R315.2
~CARTS: IC203.3, J201.32
~E: IC203.1, J201.12, R226.2
~HALT: IC206.40 (~HALT), J201.1, R206.1
~IOS: IC203.10, IC203.11, IC207.23 (CS2B)
~IRQ: IC206.3 (~IRQ), IC207.21 (IRQB), J201.36, R203.1
~NMI: IC206.2 (~NMI), J201.34, R202.1
~P7: IC301.5 (A8), Q303.3 (C), R339.1
~RAMP: IC207.17 (PB7), R322.2
~RAMS: IC203.5, IC203.8, IC204.8 (~CS), IC205.8 (~CS)
~RESET: C224.1, C228.1, D201.2 (A), IC206.37 (~RESET), IC207.34 (RESB), IC208.16 (~RESET), R201.2, R208.1
~ROMOE: IC201.22 (~OE), IC202.8
~ROMS: IC201.20 (~CE), IC202.6, IC203.12
~ZERO: IC207.39 (CA2), R324.2

Notes on the sheet:
LOCATED NEAR J203
DIGITAL GROUND
+5V DIGITAL
AUDIO
BYPASS GROUND
CARTRIDGE RECEPTICLE
-5V ANALOGIC
VIDEO
POWER
+5V ANALOGIC
ANALOGIC GROUND
RIGHT CONTROLLER
Code 0 -> 1.0mA out
LEFT CONTROLLER
