Guimli/Vectrex-Schematic/PowerBoard/PowerBoard.kicad_sch

## KiCad design PowerBoard/PowerBoard.kicad_sch (2025-01-22)

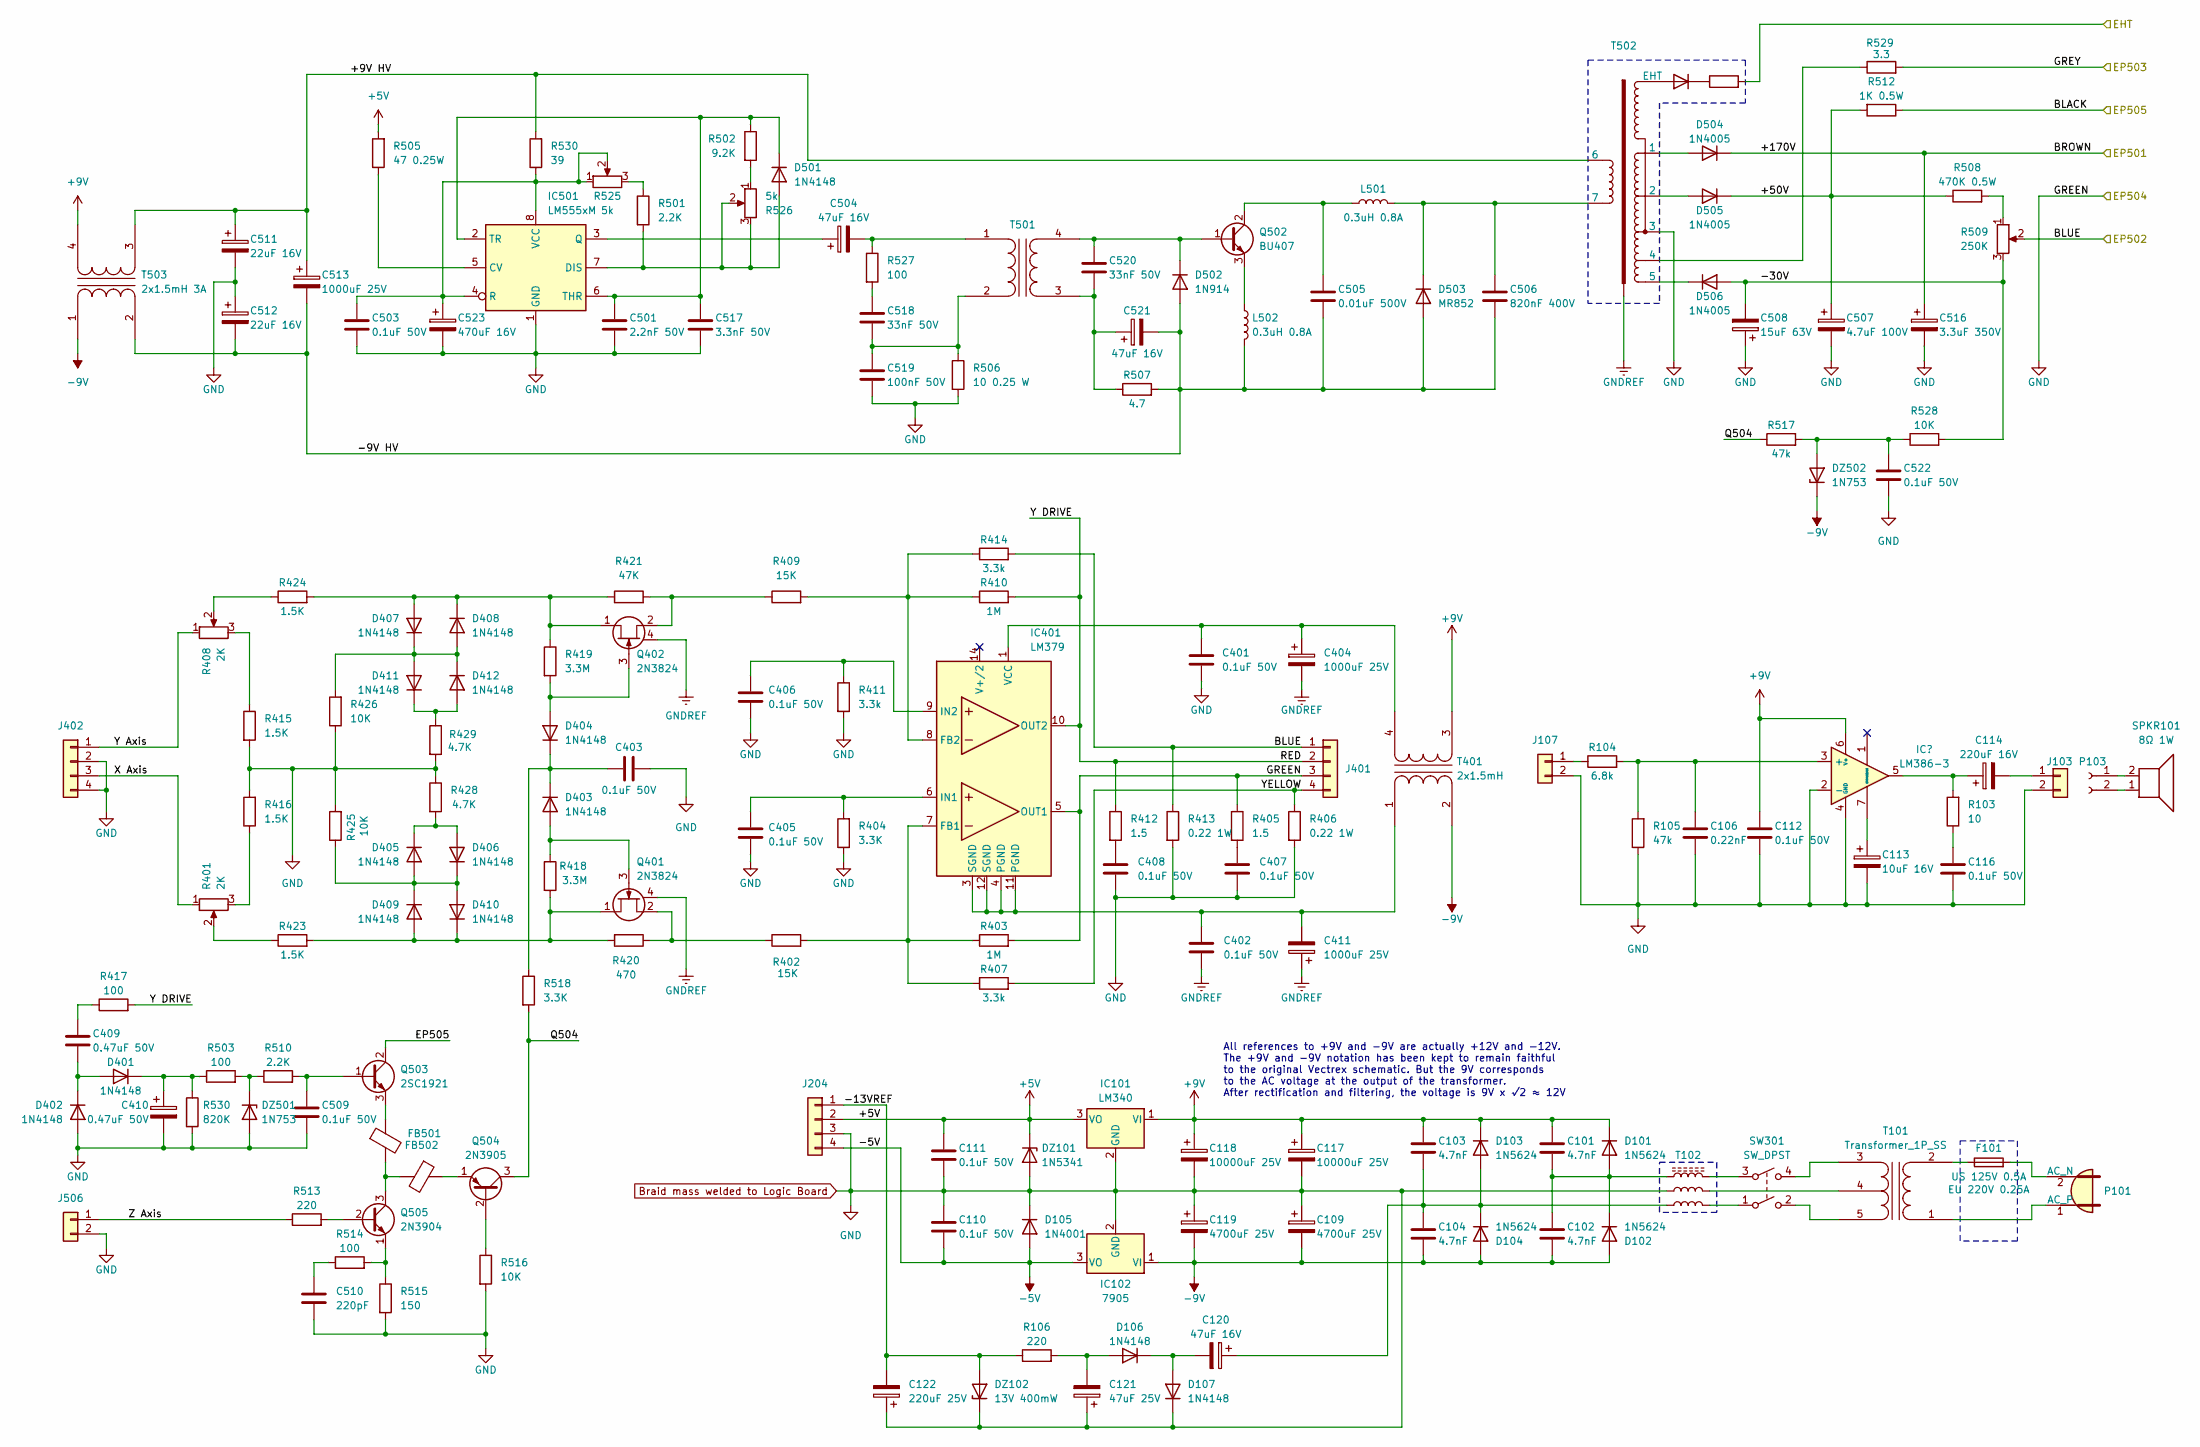
[picture p7: schematic PowerBoard.kicad_sch]

Parts:
C101, C102, C103, C104: 4.7nF
C106: 0.22nF
C109, C119: 4700uF 25V
C110, C111, C112, C116, C401, C402, C403, C405, C406, C407, C408, C503, C509, C522: 0.1uF 50V
C113: 10uF 16V
C114: 220uF 16V
C117, C118: 10000uF 25V
C120, C504, C521: 47uF 16V
C121: 47uF 25V
C122: 220uF 25V
C404, C411, C513: 1000uF 25V
C409, C410: 0.47uF 50V
C501: 2.2nF 50V
C505: 0.01uF 500V
C506: 820nF 400V
C507: 4.7uF 100V
C508: 15uF 63V
C510: 220pF
C511, C512: 22uF 16V
C516: 3.3uF 350V
C517: 3.3nF 50V
C518, C520: 33nF 50V
C519: 100nF 50V
C523: 470uF 16V
D101, D102, D103, D104: 1N5624
D105: 1N4001
D106, D107, D401, D402, D403, D404, D405, D406, D407, D408, D409, D410, D411, D412: 1N4148
D501: 1N4148; D_DO-35_SOD27_P7.62mm_Horizontal
D502: 1N914; D_DO-35_SOD27_P7.62mm_Horizontal
D503: MR852
D504, D505, D506: 1N4005; D_DO-41_SOD81_P10.16mm_Horizontal
DZ101: 1N5341
DZ102: 13V 400mW
DZ501, DZ502: 1N753
F101: US 125V 0.5A
FB501, FB502: FerriteBead
IC101: LM340; TO-252-2
IC102: 7905; TO-252-2
IC401: LM379
IC501: LM555xM; SOIC-8_3.9x4.9mm_P1.27mm
J103, J107, J506: Conn_01x02
J204, J401, J402: Conn_01x04
L501, L502: 0.3uH 0.8A
P101: Conn_WallPlug
P103: Conn_01x02_Female
Q401, Q402: 2N3824; TO-72-4
Q502: BU407
Q503: 2SC1921
Q504: 2N3905; TO-92_Inline
Q505: 2N3904; TO-92_Inline
R103: 10
R104: 6.8k
R105, R517: 47k
R106, R513: 220
R401, R408: 2K
R402, R409: 15K
R403, R410: 1M
R404, R518: 3.3K
R405, R412: 1.5
R406, R413: 0.22 1W
R407, R411, R414: 3.3k
R415, R416, R423, R424: 1.5K
R417, R503, R514, R527: 100
R418, R419: 3.3M
R420: 470
R421: 47K
R425, R426, R516, R528: 10K
R428, R429: 4.7K
R501, R510: 2.2K
R502: 9.2K
R505: 47 0.25W
R506: 10 0.25 W
R507: 4.7
R508: 470K 0.5W
R509: 250K
R512: 1K 0.5W
R515: 150
R525, R526: 5k
R529: 3.3
R530: 820K
SPKR101: 8Ω 1W
SW301: SW_DPST
T101: Transformer_1P_SS
T102: T102
T401: 2x1.5mH
T501: Transformer_1P_1S
T502: Transfo_CRT
T503: 2x1.5mH 3A

Connections:
+5V: C111.1, DZ101.1 (K), IC101.3 (VO), J204.2
+9V HV: C511.1, C513.1, R530.2, T502.6, T503.3 (SA)
+50V: C507.1, D505.1 (K), R508.1, R512.2
+170V: C516.1, D504.1 (K)
-5V: C110.2, D105.1 (A), IC102.3 (VO), J204.4
-9V HV: C505.2, C506.2, C512.2, C513.2, C521.2, D502.2 (A), D503.1 (A), L502.2, R507.2, T503.2 (AB)
-13VREF: C122.2, DZ102.2 (A), J204.1, R106.1
-30V: C508.2, D506.2 (A), R509.3, R528.2
BLACK: R512.1
BLUE: J401.1, R413.1, R414.2, R509.2
Braid mass welded to Logic Board: C109.1, C110.1, C111.2, C117.2, C118.2, C119.1, C121.1, C122.1, D105.2 (K), D107.2 (K), DZ101.2 (A), DZ102.1 (K), IC101.2 (GND), IC102.2 (GND), J204.3, T102.1
EP503: R529.2
EP504: IC401.5 (OUT1), J401.3, R403.2, R405.1
EP505: Q503.2 (C)
GND: C106.2, C112.1, C113.2, C116.2, C401.2, C501.1, C503.2, C507.2, C508.1, C510.2, C511.2, C512.1, C516.2, C517.2, C519.2, C523.2, IC501.1 (GND), J103.2, J107.2, J402.2, J402.4, J506.2, R105.1, R415.2, R416.2, R425.2, R426.1, R428.1, R429.2, R506.2, R515.2, R516.2, T502.3
GNDREF: C402.2, C404.2, C411.1, T502.
unnamed: C101.1, C103.2, C117.1, C118.1, D101.2 (K), D103.2 (K), IC101.1 (VI)
unnamed: C101.2, C102.1, D101.1 (A), D102.2 (K), T102.1
unnamed: C102.2, C104.1, C109.2, C119.2, D102.1 (A), D104.1 (A), IC102.1 (VI)
unnamed: C103.1, C104.2, C120.1, D103.1 (A), D104.2 (K), T102.1
unnamed: C106.1, R104.2, R105.2
unnamed: C114.1, R103.2
unnamed: C114.2, J103.1
unnamed: C116.1, R103.1
unnamed: C120.2, D106.2 (K), D107.1 (A)
unnamed: C121.2, D106.1 (A), R106.2
unnamed: C401.1, C404.1, IC401.1 (VCC), T401.4 (SB)
unnamed: C402.1, C411.2, IC401.3 (SGND), IC401.4 (PGND), IC401.11 (PGND), IC401.12 (SGND), T401.1 (AA)
unnamed: C403.1, D403.2 (K), D404.2 (K), R518.1
unnamed: C405.2, IC401.6 (IN1), R404.2
unnamed: C406.2, IC401.9 (IN2), R411.1
unnamed: C407.1, R405.2
unnamed: C407.2, C408.2, R406.2, R413.2
unnamed: C408.1, R412.2
unnamed: C409.1, R417.1
unnamed: C409.2, D401.1 (A), D402.2 (K)
unnamed: C410.1, D401.2 (K), R503.1, R530.1
unnamed: C410.2, C509.2, D402.1 (A), DZ501.2 (A), R530.2
unnamed: C501.2, C517.1, D501.1 (K), IC501.2 (TR), IC501.6 (THR), R502.1
unnamed: C503.1, C523.1, IC501.4 (R), IC501.8 (VCC), R525.1, R525.2, R530.1
unnamed: C504.1, IC501.3 (Q)
unnamed: C504.2, R527.1, T501.1 (AA)
unnamed: C505.1, L501.1, Q502.2 (C)
unnamed: C506.1, D503.2 (K), L501.2, T502.7
unnamed: C509.1, Q503.1 (B), R510.2
unnamed: C510.1, R514.1
unnamed: C518.1, R527.2
unnamed: C518.2, C519.1, R506.1, T501.2 (AB)
unnamed: C520.1, D502.1 (K), Q502.1 (B), T501.4 (SB)
unnamed: C520.2, C521.1, R507.1, T501.3 (SA)
unnamed: C522.1, DZ502.2 (A), R517.2, R528.1
unnamed: D403.1 (A), Q401.3 (G), R418.1
unnamed: D404.1 (A), Q402.3 (G), R419.2
unnamed: D405.1 (A), D406.2 (K), D409.2 (K), D410.1 (A), R425.1
unnamed: D405.2 (K), D406.1 (A), R428.2
unnamed: D407.1 (A), D408.2 (K), Q402.1 (D), R419.1, R421.1, R424.2
unnamed: D407.2 (K), D408.1 (A), D411.1 (A), D412.2 (K), R426.2
unnamed: D409.1 (A), D410.2 (K), Q401.1 (D), R418.2, R420.2, R423.2
unnamed: D411.2 (K), D412.1 (A), R429.1
unnamed: D501.2 (A), IC501.7 (DIS), R501.2, R526.2, R526.3
unnamed: D504.2 (A), T502.1
unnamed: D505.2 (A), T502.2
unnamed: D506.1 (K), T502.5
unnamed: DZ501.1 (K), R503.2, R510.1
unnamed: F101.1, T101.2 (AB)
unnamed: F101.2, P101.2 (AC_N)
unnamed: FB501.1, Q503.3 (E)
unnamed: FB501.2, FB502.2, Q505.3 (C)
unnamed: FB502.1, Q504.1 (E)
unnamed: IC401.7 (FB1), R402.2, R403.1, R407.1
unnamed: IC401.8 (FB2), R409.2, R410.1, R414.1
unnamed: IC501.5 (CV), R505.1
unnamed: J107.1, R104.1
unnamed: L502.1, Q502.3 (E)
unnamed: P101.1 (AC_P), T101.1 (AA)
unnamed: P103.1, SPKR101.2
unnamed: P103.2, SPKR101.1
unnamed: Q401.2 (S), R402.1, R420.1
unnamed: Q402.2 (S), R409.1, R421.2
unnamed: Q504.2 (B), R516.1
unnamed: Q505.1 (E), R514.2, R515.1
unnamed: Q505.2 (B), R513.2
unnamed: R401.2, R423.1
unnamed: R401.3, R416.1
unnamed: R408.2, R424.1
unnamed: R408.3, R415.1
unnamed: R501.1, R525.3
unnamed: R502.2, R526.1
unnamed: R508.2, R509.1
unnamed: R529.1, T502.4
unnamed: SW301.1, T102.2
unnamed: SW301.2, T101.5 (SB)
unnamed: SW301.3, T102.2
unnamed: SW301.4, T101.3 (SA)
unnamed: T101.4 (SC), T102.2
Q504: Q504.3 (C), R517.1, R518.2
RED: IC401.10 (OUT2), J401.2, R410.2, R412.1, R417.2
X Axis: J402.3, R401.1
Y Axis: J402.1, R408.1
YELLOW: J401.4, R406.1, R407.2
Z Axis: J506.1, R513.1

Notes on the sheet:
All references to +9V and -9V are actually +12V and -12V. The +9V and -9V notation has been kept to remain faithful to the original Vectrex schematic. But the 9V corresponds to the AC voltage at the output of the transformer. After rectification and filtering, the voltage is 9V x √2 ≈ 12V
