Guimli/Vectrex-Schematic/(commit log)

2022-04-05 FIRQ & CA1
    Replace Label SW3 & SW7 by FIRQ & CA1 for more visibility.
    [LogicBoard 3GE.kicad_sch]
2022-04-20 Minor location adjustment
    Minor location adjustment for better readability
    [PowerBoard.kicad_sch]
2022-04-30 Minor cleannig
    Delete a redundant wire on IC208 pin 3
    [LogicBoard 3GE.kicad_sch]
2022-07-18 Correct inversion on IC301 bus
    [LogicBoard 3GE.kicad_sch]
2022-07-23 Add invisble label for BoardView
    [LogicBoard 3GE.brd, LogicBoard 3GE.kicad_sch]
2022-07-29 Correct BoardView
    [Vectrex_LogicBoard_3GE.brd]
2022-09-06 Added a comment about the 9V voltage which is not 9V...
    [LogicBoard 3GE.kicad_sch, PowerBoard.kicad_sch]
2025-01-22 correction to the LM379 on the PowerBoard
    - Convert to Kicad 8
    - Correction to the LM379 on the PowerBoard and C405,C406,R404,R411
    - Correct value of F101
    [CRTBoard.kicad_pcb, CRTBoard.kicad_sch, LogicBoard 3GE.kicad_sch, PowerBoard.kicad_pcb, PowerBoard.kicad_sch, Vectrex_LogicBoard_3GE.brd]
2025-01-22 Deleting unnecessary directories
    [R_Axial_DIN0207_L6.3mm_D2.5mm_P12.70mm_Horizontal.FCStd, R_Axial_DIN0207_L6.3mm_D2.5mm_P12.70mm_Horizontal.step]
